inimodo/ZK-48/README.md

# ZK-48
For the technical documention and all other information surrounding this project, please read *zk_48_documentation.pdf*
