inimodo/ZK-48/Documentation/LaTeX/zk_48_appendix.tex

\section{Appendix}
\subsection{Pricing}

\begin{table}[!ht]
    \centering
    \begin{tabular}{|l|l|l|l|}
    \hline
        Name & Amount & Price (EUR) & Total (EUR)  \\ \hline \hline
        Transistors & 48 & 0.09 & 4.32 \\ \hline
        Resistors & 105 & 0.012 & 1.26  \\ \hline
        Resistors 15Ohm & 48 & 0.05 & 2.42 \\ \hline
        Buzzer & 2 & 1.00 & 2.00  \\ \hline
        Perfboard & 2 & 2.725 & 5.45 \\ \hline
        Speaker Terminal & 18 & 0.404 & 7.272\\ \hline
        MAB 5 (Plug) & 7 & 0.72 & 5.04  \\ \hline
        MAS 50 (Socket) & 7 & 0.675 & 4.725  \\ \hline
        74HC595 & 6 & 0.313 & 1.878  \\ \hline
        74LS139 & 1 & 0.81 & 0.81  \\ \hline
        Attiny 861 & 1 & 2.42 & 2.42\\ \hline
        UART-To-TTL Converter & 1 & 4.02 & 4.02  \\ \hline
        Solder & 1 & 12.02 & 12.02 \\ \hline
        Power Bank & 1 & 20.16 & 20.16  \\ \hline
        Gun case & 1 & 22.99 & 22.99 \\ \hline
        Ignition Module case & 6 & 3.99 & 23.94  \\ \hline
        Telephone Cable & 1 & 24.79 & 24.79  \\ \hline
        Trigger ABS housing & 1 & 4.99 & 4.99  \\ \hline
        Cost for Buttons , Switches and LEDs (ca.) & 1 & 10.00 & 10.00 \\ \hline
        Screws and Standoffs (ca.) & 1 & 10.00 & 10.00 \\ \hline
        Capcaitors,Diodes,Relays, IC's and more (ca.) & 1 & 15.00 & 15.00  \\ \hline\hline
        ~ & ~ & ~ & 185.50
  \\ \hline
    \end{tabular}
    \caption{All parts of the ZK-48 listed with prices. higher.}
    \label{tab:cost}
\end{table}

\noindent In \Cref{tab:cost}, the cost of the complete system is split into all parts that make it up. Some values are estimates, as some parts were not bought specifically for this project, instead were already on hand, which could result in a lower price or higher depending on the source. Not considering the many months of development, a price of about 185.50 Euro is comparatively low, as the price range for similar systems(even without programming capability) range from 400 Euro \footurl{https://www.firework-shop.de/Funkzuendanlage-48-Kanal-DBR01-X4-48::104404.html} to 700 Euro \footurl{https://feuerwerkershop.de/produkt/funkzuendanlagen/sonstige-zuendanlagen/48-kanal-zuendanlage-db24-set/}. \\

\subsection{Recognitions}
\label{Recognitions}
All circuits were drawn with the help of $KiCad\ 6.0$\footurl{https://www.kicad.org/}\\

\noindent All flowcharts and diagrams were drawn with the help of $Drawio$\footurl{https://app.diagrams.net/}

\pagebreak

\subsection{Firmware Code}

\lstinputlisting{../../Firmware/ZK_48_Firmware/ZK_48_Firmware.ino}

\vspace{2cm}
