inimodo/ZK-48/Documentation/LaTeX/zk_48_documentation.tex

\input{./praeambel.tex}

\title{ZK-48 Technical Documentation}
\author{Markus K.}
\date{2023}

\begin{document}

\begin{titlepage}
\begin{center}
\vspace*{1cm}
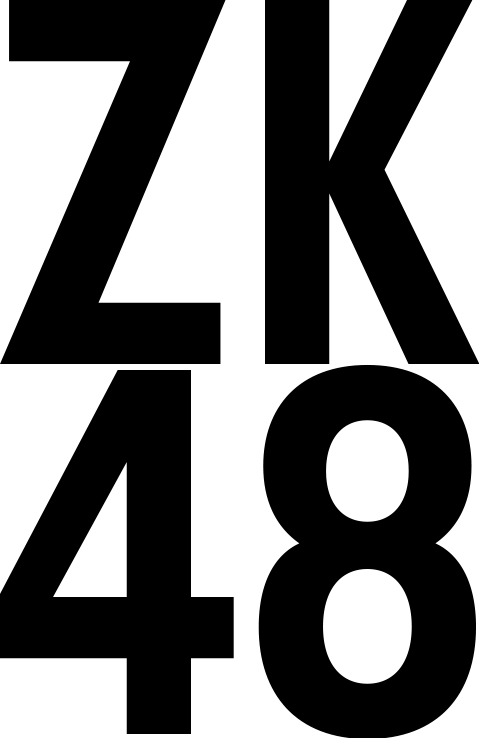
[picture p24: Documentation/LaTeX/Figures/zk_48_logo.png]

\vspace*{1cm}

\Huge {Technical Documentation\\} 
\vspace*{0.5cm}
\Huge{\textbf{Programmable 48 Output \\ Wired Pyrotechnic Ignition System\\ based on the ATTINY 861\\}}
\vspace*{12cm} 
\Large{Markus Kotar\\}
\vspace*{0.5cm}
\Large{04.10.2023}

\end{center}
\end{titlepage}

\pagebreak 

\tableofcontents

\pagebreak

\include{./zk_48_introduction.tex}
\include{./zk_48_hardware.tex}
\include{./zk_48_firmware.tex}
\include{./zk_48_appendix.tex}

\end{document}
