inimodo/ZK-48/Documentation/LaTeX/praeambel.tex

%Schriftart Format
\documentclass{article}
\usepackage[english]{babel}
\usepackage[utf8]{inputenc}
\usepackage[T1]{fontenc}
\usepackage{geometry}
\geometry{a4paper, portrait, margin=20mm, headsep= 15pt , headheight = 19pt, footskip = 15 pt}
\usepackage[]{placeins}
\usepackage{hyperref}

\usepackage[bottom]{footmisc} 

%Grafik:
\usepackage{graphicx}

%Kopfzeile:
\usepackage{fancyhdr}
\pagestyle{fancy}
\fancyhf{}
\fancyhead[L]{\Large ZK-48}
\fancyhead[C]{\Large Technical Documentation}
\fancyhead[R]{\Large Page \thepage}
\cfoot{}

\setlength{\footskip}{40pt}

%Formeln:
\usepackage{amsmath, amsthm, amssymb}

\usepackage{cleveref}

%Code-darstellen:
\usepackage{listingsutf8}
\usepackage[numbered,framed]{matlab-prettifier}
\lstset{language=Python}
\lstset{literate=
  {á}{{\'a}}1 {é}{{\'e}}1 {í}{{\'i}}1 {ó}{{\'o}}1 {ú}{{\'u}}1
  {Á}{{\'A}}1 {É}{{\'E}}1 {Í}{{\'I}}1 {Ó}{{\'O}}1 {Ú}{{\'U}}1
  {à}{{\`a}}1 {è}{{\`e}}1 {ì}{{\`i}}1 {ò}{{\`o}}1 {ù}{{\`u}}1
  {À}{{\`A}}1 {È}{{\'E}}1 {Ì}{{\`I}}1 {Ò}{{\`O}}1 {Ù}{{\`U}}1
  {ä}{{\"a}}1 {ë}{{\"e}}1 {ï}{{\"i}}1 {ö}{{\"o}}1 {ü}{{\"u}}1
  {Ä}{{\"A}}1 {Ë}{{\"E}}1 {Ï}{{\"I}}1 {Ö}{{\"O}}1 {Ü}{{\"U}}1
  {â}{{\^a}}1 {ê}{{\^e}}1 {î}{{\^i}}1 {ô}{{\^o}}1 {û}{{\^u}}1
  {Â}{{\^A}}1 {Ê}{{\^E}}1 {Î}{{\^I}}1 {Ô}{{\^O}}1 {Û}{{\^U}}1
  {ã}{{\~a}}1 {ẽ}{{\~e}}1 {ĩ}{{\~i}}1 {õ}{{\~o}}1 {ũ}{{\~u}}1
  {Ã}{{\~A}}1 {Ẽ}{{\~E}}1 {Ĩ}{{\~I}}1 {Õ}{{\~O}}1 {Ũ}{{\~U}}1
  {œ}{{\oe}}1 {Œ}{{\OE}}1 {æ}{{\ae}}1 {Æ}{{\AE}}1 {ß}{{\ss}}1
  {ű}{{\H{u}}}1 {Ű}{{\H{U}}}1 {ő}{{\H{o}}}1 {Ő}{{\H{O}}}1
  {ç}{{\c c}}1 {Ç}{{\c C}}1 {ø}{{\o}}1 {å}{{\r a}}1 {Å}{{\r A}}1
  {€}{{\euro}}1 {£}{{\pounds}}1 {«}{{\guillemotleft}}1
  {»}{{\guillemotright}}1 {ñ}{{\~n}}1 {Ñ}{{\~N}}1 {¿}{{?`}}1 {¡}{{!`}}1 
}

\usepackage{float}
\usepackage{siunitx}

\makeatletter
\renewcommand\paragraph{\@startsection{paragraph}{4}{\z@}%
            {-2.5ex\@plus -1ex \@minus -.25ex}%
            {1.25ex \@plus .25ex}%
            {\normalfont\normalsize\bfseries}}
\makeatother
\setcounter{secnumdepth}{4} % how many sectioning levels to assign numbers to
\setcounter{tocdepth}{3}    % 4 means also paragraphs
\crefname{paragraph}{paragraph}{paragraphs}
\Crefname{paragraph}{Paragraph}{Paragraphs}

% My commands :)

\newcommand{\sourceurl}[3]{\noindent \textit{\small{Source of #1 \cref{#2}: \url{#3}}}\\}

\newcommand{\footurl}[1]{\footnote{\url{#1}}}

\lstdefinestyle{myStyle}{
    belowcaptionskip=1\baselineskip,
    breaklines=true,
    frame=none,
    numbers=none, 
    basicstyle=\footnotesize\ttfamily,
    keywordstyle=\bfseries\color{green!40!black},
    commentstyle=\itshape\color{purple!40!black},
    identifierstyle=\color{blue},
    backgroundcolor=\color{gray!10!white},
}

\lstset { %C++ Lisiting
    language=C++,
    backgroundcolor=\color{white} % set backgroundcolor
    basicstyle=\tiny, %ttfamily
    keywordstyle=\color{blue}\ttfamily,
    stringstyle=\color{red}\ttfamily,
    commentstyle=\color{gray}\ttfamily,
    morecomment=[l][\color{purple}]{\#},
    numbers=left
}

\crefname{lstlisting}{listing}{listings}
\Crefname{lstlisting}{Listing}{Listings}
