inimodo/ZK-48/Documentation/Charts/connector_mod.png

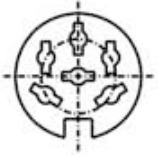
Documentation/Charts/connector_mod.png
