inimodo/ZK-48/Documentation/Charts/connector_trig.png

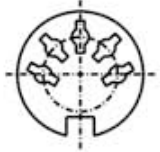
Documentation/Charts/connector_trig.png
