inimodo/ZK-48/Documentation/Cost.xlsx

Name | Pieces | Price | Total | Total: | 185.5042
Transistors | 48 | 0.09 | 4.32
Resistors | 105 | 0.012 | 1.26
Resistors 15Ohm | 48 | 0.0504 | 2.4192
Buzzer | 2 | 1 | 2
Prefboard | 2 | 2.725 | 5.45
Speaker Terminal | 18 | 0.404 | 7.272
MAB 5 (Plug) | 7 | 0.72 | 5.04
MAS 50 (Socket) | 7 | 0.675 | 4.725
74HC595 | 6 | 0.313 | 1.878
74LS139 | 1 | 0.81 | 0.81
Attiny861 | 1 | 2.42 | 2.42
UART-TTL | 1 | 4.02 | 4.02
Solder | 1 | 12.02 | 12.02
Power Bank | 1 | 20.16 | 20.16
Gun case | 1 | 22.99 | 22.99
Ignition Module case | 6 | 3.99 | 23.94
Cost for Buttons , Switches and LEDs (ca.) | 1 | 10 | 10
Telephone Cable | 1 | 24.79 | 24.79
Screws and Standoffs (ca.) | 1 | 10 | 10
Trigger ABS housing | 1 | 4.99 | 4.99
Capcaitors,Diodes,Relays, IC's and more (ca.) | 1 | 15 | 15
 |  |  | 0
 |  |  | 0
 |  |  | 0
 |  |  | 0
 |  |  | 0
 |  |  | 0
 |  |  | 0
 |  |  | 0
 |  |  | 0
 |  |  | 0
 |  |  | 0
 |  |  | 0
 |  |  | 0
 |  |  | 0
